Emilio-Guadarrama/MAGNIS-v1-GroundStation/Docs/MAGNIS-v1_Schematic.pdf

RGB Status Indicators — WS2812B | Magnetic Buzzer — MLT-8530 1 2 | R3

# ESP32-DevKitC V4

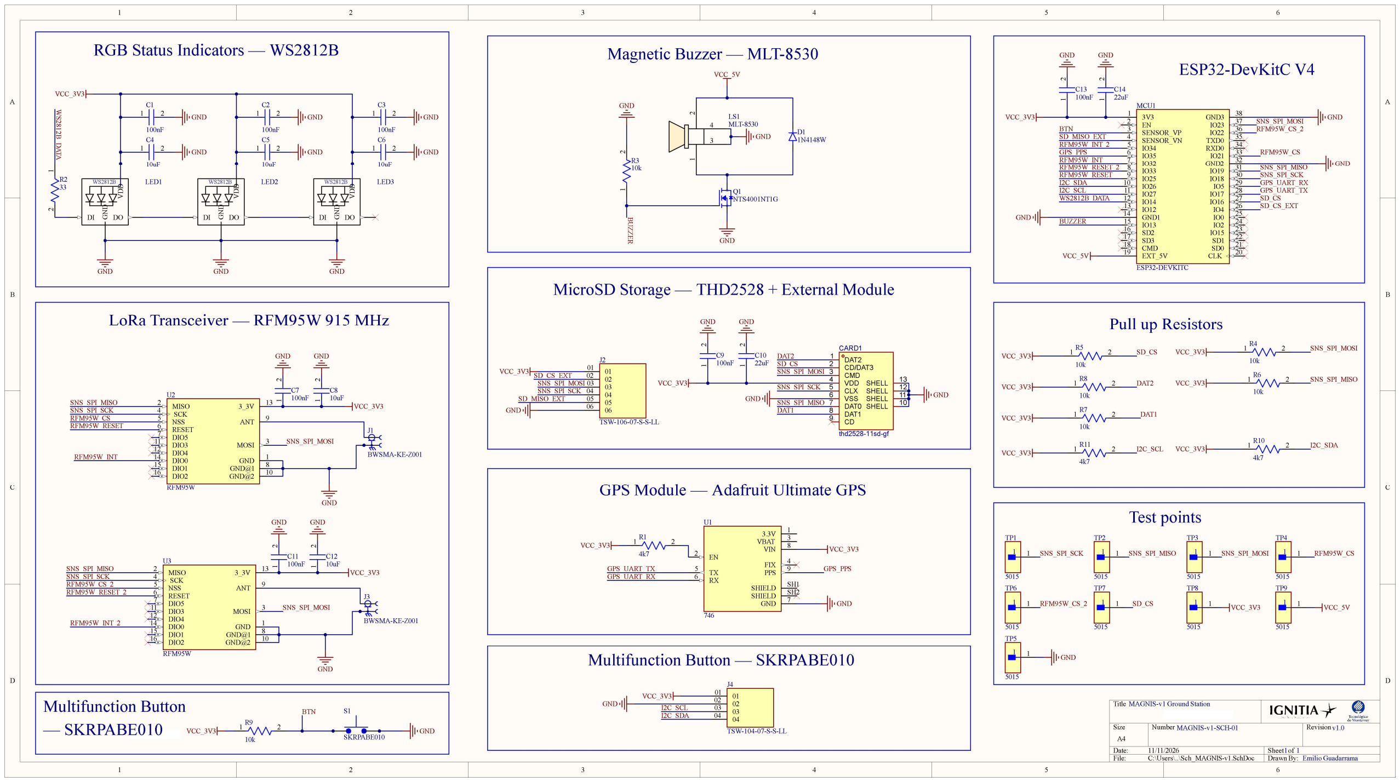
[picture p6: page 1]

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
Title

Size | Number | Revision
A4
Date: | 11/11/2026 | Sheet of
File: | C:\Users\..\Sch_MAGNIS-v1.SchDoc | Drawn By:

3V3 1
EN 2
SENSOR_VP 3
SENSOR_VN 4
IO34 5
IO35 6
IO32 7
IO33 8
IO25 9
IO26 10
IO27 11
IO14 12
IO12 13
GND1 14
IO13 15
SD2 16
SD3 17
CMD 18
EXT_5V 19
GND3 | 38
IO23 | 37
IO22 | 36
TXD0 | 35
RXD0 | 34
IO21 | 33
GND2 | 32
IO19 | 31
IO18 | 30
IO5 | 29
IO17 | 28
IO16 | 27
IO4 | 26
IO0 | 25
IO2 | 24
IO15 | 23
SD1 | 22
SD0 | 21
CLK | 20

MCU1

ESP32-DEVKITC

Emilio Guadarrama

1 1

v1.0

MAGNIS-v1 Ground Station

MAGNIS-v1-SCH-01

1 2
R2
33

1 2

C1

100nF

1 2

C4

10uF

GND

GND

1 2

C2

100nF

1 2

C5

10uF

GND

GND

1 2

C3

100nF

1 2

C6

10uF

GND

GND

GND | GND | GND

VCC_3V3

10k

GND

GND

VCC_5V

GND

WS2812B GND DOVDD

DI

LED1 | WS2812B GND DOVDD

DI

LED2 | WS2812BGND DOVDD

DI

LED3 | BUZZER WS2812B_DATA

VCC_5V

GND

GND

GND

VCC_3V3

J1

BWSMA-KE-Z001 ¹ ² C7

100nF 1 2 | C8
| 10uF
GND | GND

VCC_3V3

# LoRa Transceiver — RFM95W 915 MHz

GND

VCC_3V3

1 2 R1

4k7

VCC_3V3

# GPS Module — Adafruit Ultimate GPS

GND

RFM95W_RESET

SNS_SPI_MOSI

SNS_SPI_MISO
SNS_SPI_SCK
RFM95W_CS

RFM95W_INT

GPS_UART_TX
GPS_UART_RX

01 01
02 02
03 03
04 04
05 05
06 06

J2

TSW-106-07-S-S-LL

DAT2 1
CD/DAT3 2
CMD 3
VDD 4
CLX 5
VSS 6
DAT0 7
DAT1 8
CD 9
SHELL | 10 SHELL | 11 SHELL | 12 SHELL | 13

CARD1

thd2528-11sd-gf

VCC_3V3

GND

SNS_SPI_MOSI

SNS_SPI_SCK

SNS_SPI_MISO

DAT1 ¹ ² C9

100nF 1 2 | C10
| 22uF
GND | GND | Pull up Resistors

SNS_SPI_MOSI

SNS_SPI_MISO

DAT1

1 2 R4

10k

1 2 R6

10k

1 2 R7

10k

VCC_3V3

VCC_3V3

VCC_3V3

VCC_3V3
SNS_SPI_MOSI
SNS_SPI_SCK

GND

SD_MISO_EXT

DAT2

1 | 2 | DAT2 R8

10k

VCC_3V3

SD_CS

RFM95W_INT

RFM95W_RESET

WS2812B_DATA

GPS_UART_RX
GPS_UART_TX

SNS_SPI_SCK

SNS_SPI_MISO

SNS_SPI_MOSI

SD_CS

GPS_PPS

RFM95W_INT_2

SD_CS_EXT

SD_CS_EXT

RFM95W_CS

SD_MISO_EXT

1 | 2 | SD_CS R5

10k

VCC_3V3

GND

GPS_PPS

# MicroSD Storage — THD2528 + External Module

EN 2

TX 5
RX 6
3.3V | 1
VBAT | 3
VIN | 8
FIX | 4
PPS | 9
SHIELD | SH1
SHIELD | SH2
GND | 7

U1

746

MISO 2
SCK 4
NSS 5
RESET 6
DIO5 7
DIO3 11
DIO4 12
DIO0 14
DIO1 15
DIO2 16
3_3V | 13
ANT | 9
MOSI | 3
GND | 1
GND@1 | 8
GND@2 | 10

U2

RFM95W | 1 2 | 3
| | 4

LS1
MLT-8530
D1
1N4148W

Q1
NTS4001NT1G

J3

BWSMA-KE-Z001 ¹ ² C11

100nF 1 2 | C12
| 10uF
GND | GND

VCC_3V3

GND

RFM95W_RESET_2

SNS_SPI_MOSI

SNS_SPI_MISO
SNS_SPI_SCK
RFM95W_CS_2

RFM95W_INT_2

MISO 2
SCK 4
NSS 5
RESET 6
DIO5 7
DIO3 11
DIO4 12
DIO0 14
DIO1 15
DIO2 16
3_3V | 13
ANT | 9
MOSI | 3
GND | 1
GND@1 | 8
GND@2 | 10

U3

RFM95W

RFM95W_CS_2

RFM95W_RESET_2

BUZZER

Multifunction Button | S1

SKRPABE010

1 2 R9

10k

VCC_3V3

BTN

I2C_SDA

01 01
02 02
03 03
04 04

J4

TSW-104-07-S-S-LL

# Multifunction Button — SKRPABE010

VCC_3V3
GND | I2C_SCL
| I2C_SDA

I2C_SCL

# — SKRPABE010

# Test points

1 | 2 | I2C_SDA R10

4k7

1 | 2 | I2C_SCL | VCC_3V3 R11

4k7

VCC_3V3 | 1 2 | C13
100nF 1 2 | C14

22uF

GND | GND

1 1

TP1

5015

SNS_SPI_SCK

1 1

TP6

5015

RFM95W_CS_2

1 1

TP2

5015

SNS_SPI_MISO

1 1

TP7

5015

SD_CS

1 1

TP3

5015

SNS_SPI_MOSI

1 1

TP8

5015

1 1

TP4

5015

RFM95W_CS

1 1

TP9

5015

1 1

TP5

5015

VCC_3V3 | VCC_5V

GND

GND

BTN
