Emilio-Guadarrama/MAGNIS-v1-GroundStation/PCB_Project_MAGNIS-v1-GroundStation/Images/Background.jpg

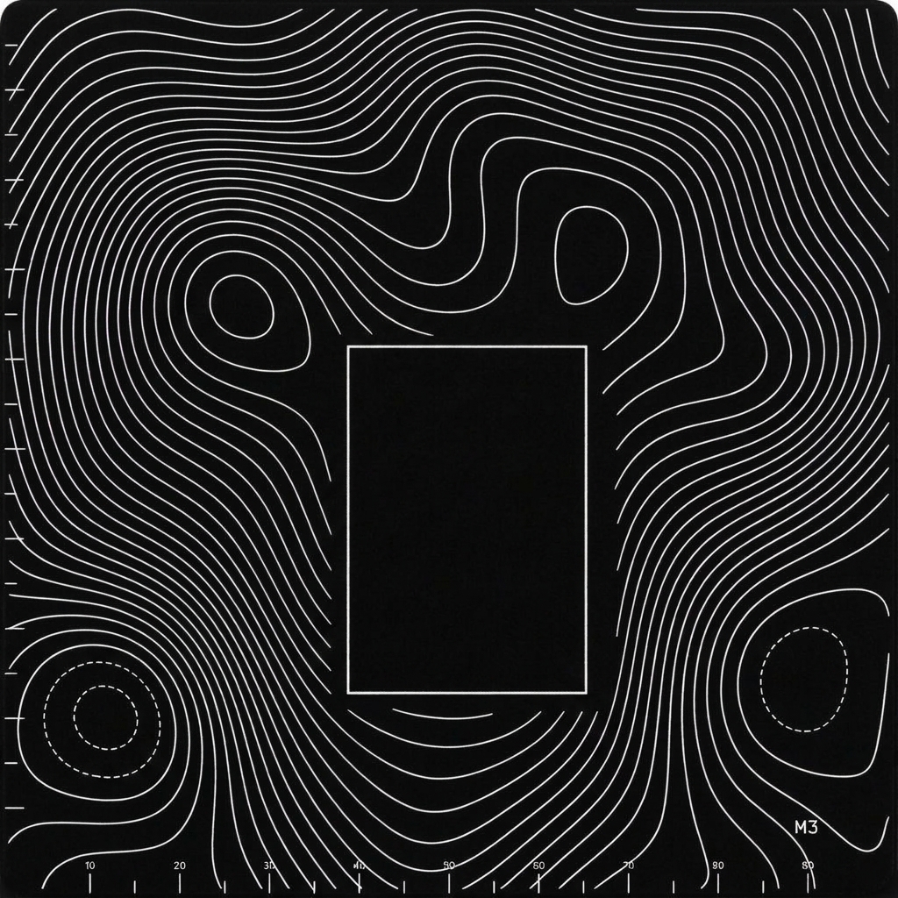
PCB_Project_MAGNIS-v1-GroundStation/Images/Background.jpg
