Emilio-Guadarrama/MAGNIS-v1-GroundStation/VESTA_v1_Parts_List.xlsx

VESTA v1 ground station component list (rev A) |  |  |  |  |  |  |  |  | Boards to build | 3 | ← edit: 2 boards for diversity + 1 spare (assumption, change freely)
Green = approved, at UNIT Electronics · White = reused from V5 (same part and footprint) · Yellow = needs a decision or a special order · Grey = DNP or PCB copper only. UNIT is the primary source (assembly in Mexico); LCSC, Mouser and DigiKey are backups. SnapMagic 'Part page' = dedicated symbol + footprint page; 'Search' = no dedicated page found, reuse the V5 footprint where noted. V5 links checked Sep 24, 2026; new UNIT links found Oct 29, 2026 — stock not re-checked, confirm at checkout.
Status | Component name | ID # (part number) | Designator on schematic | Amount | Total (all boards) | UNIT Electronics | LCSC | Mouser MX | DigiKey MX | SnapMagic (symbol + footprint) | Notes
MODULES (plug-in, no soldering to the module itself)
Approved | Dev board ESP32-DevKitC V4, ESP32-WROOM-32D (4 MB flash, PCB antenna, 2×19 pins, CP2102 micro-USB) | ESP32-DevKitC-32D | MOD1 | 1 | 3 | UNIT (https://uelectronics.com/producto/esp32-devkitc-v4-esp32-wroom-32d-32u/) | — | Mouser (https://www.mouser.mx/c/?q=ESP32-DevKitC-32D) | DigiKey (https://www.digikey.com.mx/es/products/result?keywords=ESP32-DevKitC-32D) | Part page (ESP32-DEVKITC) (https://www.snapeda.com/parts/ESP32-DEVKITC/Espressif%20Systems/view-part/) | UNIT $145 MXN — choose the '32D' option (PCB antenna). The '32U' needs an external IPEX antenna. Wi-Fi is only for debug, so 32D is enough; keep copper out from under its antenna. Check that the SnapMagic symbol pin numbers match the DevKit J2/J3 order and measure the row spacing on the real board.
Request from UNIT | GPS breakout MTK3339 / PA1616S (66 ch, 10 Hz, patch antenna) | Adafruit 746 | MOD2 | 1 | 3 | Request | — | Mouser (https://www.mouser.mx/c/?q=Adafruit%20746) | DigiKey (https://www.digikey.com.mx/es/products/result?keywords=Adafruit%20746) | Not needed — mounts on J4 | Not stocked at UNIT: request a special order (allow lead time). Pin order 3.3V, EN, VBAT, FIX, TX, RX, GND, VIN, PPS — check the breakout silkscreen. VIN = 5 V; EN left NC (pull-up on breakout).
Approved | MicroSD SPI module, 6-pin (optional test module for J3) | Generic micro SD reader | MOD3 | 1 | 3 | UNIT (https://uelectronics.com/producto/lector-de-memorias-micro-sd-para-arduino/) | — | — | — | Not needed — plugs into J3 | Only for testing the backup path. Its buffer never releases MISO → own SD_MISO_EXT line (IO35). Most of these modules have an onboard LDO: set JP2 to 5 V.
POWER
Approved | LDO 3.3 V / 600 mA, 250 mV dropout, SOT-23-5 | AP2112K-3.3TRG1 | U1 | 1 | 3 | UNIT (https://uelectronics.com/producto/regulador-de-voltaje-lineal-ap2112k-3-3trg1/) | C51118 (https://www.lcsc.com/product-detail/C51118.html) | Mouser (https://www.mouser.mx/c/?q=AP2112K-3.3TRG1) | DigiKey (https://www.digikey.com.mx/es/products/result?keywords=AP2112K-3.3TRG1) | Part page (https://www.snapeda.com/parts/AP2112K-3.3TRG1/Diodes%20Inc./view-part/) | Replaces AMS1117-3.3: AMS1117 needs ≥1.1 V headroom and the DevKit 5V pin sits below 5 V on laptop USB. EN tied to VIN. Built-in current limit.
PCB only | Solder jumper, 3-pad | PCB copper only | JP1, JP2 | 2 | 0 | — | — | — | — | — | JP1 = VCC_3V3 source (U1 or devkit 3V3). JP2 = J3 VCC (5 V or 3V3). Nothing to buy.
RF
Reuse (V5 part) | LoRa transceiver 915 MHz (SX1276) | RFM95W-915S2 | U2 | 1 | 3 | UNIT (https://uelectronics.com/producto/rfm95w-915mhz-transceptor-lora/) | C6760738 (https://www.lcsc.com/product-detail/C6760738.html) | Mouser (https://www.mouser.mx/c/?q=RFM95W-915S2) | DigiKey (https://www.digikey.com.mx/es/products/result?keywords=RFM95W-915S2) | Part page (https://www.snapeda.com/parts/RFM95W-915S2/HOPERF/view-part/) | Same part and footprint as V5. ANT pad faces J1; CPWG trace ≤ 6 mm (W 1.0 mm / gap 0.18 mm, L2 = GND).
Reuse (V5 part) | SMA edge connector 50 Ω | BWSMA-KE-Z001 | J1 | 1 | 3 | UNIT (https://uelectronics.com/producto/conectores-sma-hembra-vertical-y-horizontal/) | C496549 (https://www.lcsc.com/product-detail/C496549.html) | Mouser (https://www.mouser.mx/c/?q=BWSMA-KE-Z001) | DigiKey (https://www.digikey.com.mx/es/products/result?keywords=BWSMA-KE-Z001) | Search (https://www.snapeda.com/search/?q=BWSMA-KE-Z001) | Same as V5. Must be edge-launch for a 1.6 mm board — UNIT listing is generic SMA, confirm edge-mount. No SnapMagic page: reuse the V5 footprint. GND legs = Direct Connect.
Approved | Resistor 0 Ω 0603 (π-match series) | 0603WAF0000T5E | R1 | 1 | 3 | UNIT (https://uelectronics.com/producto/resistencias-smd-0603/) | Search (https://www.lcsc.com/search?q=0603WAF0000T5E) | Mouser (https://www.mouser.mx/c/?q=0603WAF0000T5E) | DigiKey (https://www.digikey.com.mx/es/products/result?keywords=0603WAF0000T5E) | Generic — use your 0603/0805 library | Fitted by default. Swap for an inductor/capacitor only if VNA tuning says so.
DNP (footprint only) | Capacitor 0603 (π-match shunts) | — | C1, C2 | 2 | 0 | — | — | — | — | Generic — use your 0603/0805 library | Footprint only, do not populate. Values chosen after VNA tuning.
CONNECTORS & HEADERS
Reuse (V5 part) | MicroSD socket push-push (no card detect) | THD2528-11SD-GF | J2 | 1 | 3 | UNIT (https://uelectronics.com/producto/thd2528-11sd-gf-conector-para-memoria-micro-sd/) | C283232 (https://www.lcsc.com/product-detail/C283232.html) | Mouser (https://www.mouser.mx/c/?q=THD2528-11SD-GF) | DigiKey (https://www.digikey.com.mx/es/products/result?keywords=THD2528-11SD-GF) | Search (https://www.snapeda.com/search/?q=THD2528-11SD-GF) | Same socket as V5 → the GS validates it before V5 assembly. No card-detect, so no SD_DETECT line. No SnapMagic page: reuse the V5 footprint.
Approved | Female header 1×19, 2.54 mm (DevKitC sockets) | PPTC191LFBN-RC | J5, J6 | 2 | 6 | UNIT (https://uelectronics.com/producto/tira-header-hembra-2-54mm-diferentes-pines/) | — | Mouser (https://www.mouser.mx/c/?q=PPTC191LFBN-RC) | DigiKey (https://www.digikey.com.mx/es/products/result?keywords=PPTC191LFBN-RC) | Search (https://www.snapeda.com/search/?q=PPTC191LFBN-RC) | UNIT sells strips by pin count — buy 1×40 and cut (one pin lost per cut). Sullins PN is the footprint reference.
Approved | Female header 1×9, 2.54 mm (GPS breakout) | PPTC091LFBN-RC | J4 | 1 | 3 | UNIT (https://uelectronics.com/producto/tira-header-hembra-2-54mm-diferentes-pines/) | — | Mouser (https://www.mouser.mx/c/?q=PPTC091LFBN-RC) | DigiKey (https://www.digikey.com.mx/es/products/result?keywords=PPTC091LFBN-RC) | Search (https://www.snapeda.com/search/?q=PPTC091LFBN-RC) | Order must match the Adafruit 746 breakout. Keep J4 at the opposite corner from J1 (~60 mm).
Approved | Female header 1×6, 2.54 mm (external microSD module) | PPTC061LFBN-RC | J3 | 1 | 3 | UNIT (https://uelectronics.com/producto/tira-header-hembra-2-54mm-diferentes-pines/) | — | Mouser (https://www.mouser.mx/c/?q=PPTC061LFBN-RC) | DigiKey (https://www.digikey.com.mx/es/products/result?keywords=PPTC061LFBN-RC) | Search (https://www.snapeda.com/search/?q=PPTC061LFBN-RC) | Match the module pin order (typ. GND, VCC, MISO, MOSI, SCK, CS — check the module silkscreen).
Approved | Male header 1×2, 2.54 mm (MODE_SEL) | PRPC002SAAN-RC | J7 | 1 | 3 | UNIT (https://uelectronics.com/producto/tira-header-macho-40p-2-54mm-diferentes-colores/) | — | Mouser (https://www.mouser.mx/c/?q=PRPC002SAAN-RC) | DigiKey (https://www.digikey.com.mx/es/products/result?keywords=PRPC002SAAN-RC) | Search (https://www.snapeda.com/search/?q=PRPC002SAAN-RC) | Cut from a 1×40 male strip. Open = rocket config, jumper fitted = CanSat config (read at boot).
Approved | Jumper shunt 2.54 mm | QPC02SXGN-RC | — (on J7) | 1 | 3 | UNIT (https://uelectronics.com/producto/puente-corto-circuito-pin-header-2-54mm/) | — | Mouser (https://www.mouser.mx/c/?q=QPC02SXGN-RC) | DigiKey (https://www.digikey.com.mx/es/products/result?keywords=QPC02SXGN-RC) | Not needed — no footprint | Mechanical only.
PCB only | Mounting hole M3, plated | PCB copper only | H1, H2, H3, H4 | 4 | 0 | — | — | — | — | — | 3.5 mm from each corner. Nothing to buy (standoffs optional).
INDICATORS & AUDIO
Reuse (V5 part) | Addressable RGB LED 5050 | WS2812B-B/T | LED1, LED2, LED3 | 3 | 9 | UNIT (https://uelectronics.com/producto/neopixel-rgb-5x5mm-smd-ws2812b-b/) | C2761795 (https://www.lcsc.com/product-detail/C2761795.html) | Mouser (https://www.mouser.mx/c/?q=WS2812B-B/T) | DigiKey (https://www.digikey.com.mx/es/products/result?keywords=WS2812B-B/T) | Search (https://www.snapeda.com/search/?q=WS2812B-B/T) | Same as V5 — reuse the corrected LED5050 footprint. VDD = 5 V.
Pending decision | Buffer 3.3 → 5 V, single, SOT-23-5 (WS2812B data) | SN74AHCT1G125DBVR | U3 | 1 | 3 | — | Search (https://www.lcsc.com/search?q=SN74AHCT1G125DBVR) | Mouser (https://www.mouser.mx/c/?q=SN74AHCT1G125DBVR) | DigiKey (https://www.digikey.com.mx/es/products/result?keywords=SN74AHCT1G125DBVR) | Part page (https://www.snapeda.com/parts/SN74AHCT1G125DBVR/Texas%20Instruments/view-part/) | Not at UNIT → Mouser/DigiKey MX. Needed because WS2812B at 5 V wants VIH ≥ 3.5 V. If not bought: leave U3 empty and fit R3 (direct drive, same as the FC).
DNP (footprint only) | Resistor 0 Ω 0603 (bypass for U3) | 0603WAF0000T5E | R3 | 1 | 0 | UNIT (https://uelectronics.com/producto/resistencias-smd-0603/) | Search (https://www.lcsc.com/search?q=0603WAF0000T5E) | Mouser (https://www.mouser.mx/c/?q=0603WAF0000T5E) | DigiKey (https://www.digikey.com.mx/es/products/result?keywords=0603WAF0000T5E) | Generic — use your 0603/0805 library | Fit only if U3 is not populated.
Reuse (V5 part) | Red LED 0805 (power indicators) | NCD0805R1 | D1, D2, D3 | 3 | 9 | UNIT (https://uelectronics.com/producto/led-rojo-smd-0805-ncd0805r1/) | C84256 (https://www.lcsc.com/product-detail/C84256.html) | Mouser (https://www.mouser.mx/c/?q=NCD0805R1) | DigiKey (https://www.digikey.com.mx/es/products/result?keywords=NCD0805R1) | Search (https://www.snapeda.com/search/?q=NCD0805R1) | D1 = VCC_5V, D2 = VCC_3V3, D3 = RFM95W rail. Series 1 kΩ each (R4–R6).
Approved | Active buzzer 5 V, 12 mm, THT | Generic active buzzer 5 V (ref. AI-1223-TWT-5V-R) | LS1 | 1 | 3 | UNIT (https://uelectronics.com/producto/buzzer-activo-3v-5v-12v-zumbador/) | — | Mouser (https://www.mouser.mx/c/?q=AI-1223-TWT-5V-R) | DigiKey (https://www.digikey.com.mx/es/products/result?keywords=AI-1223-TWT-5V-R) | Search (https://www.snapeda.com/search/?q=AI-1223-TWT-5V-R) | Replaces V5 MLT-8530 (not at UNIT). Active type: GPIO on/off, no PWM. Pick the 5 V variant on the UNIT page; check pin pitch (typ. 7.6 mm) and polarity before freezing the footprint.
TRANSISTORS & DIODES
Reuse (V5 part) | NPN 25 V / 500 mA, SOT-23 (buzzer driver) | S8050 | Q1 | 1 | 3 | UNIT (https://uelectronics.com/producto/transistor-npn-500ma-25v-s8050/) | C2146 (https://www.lcsc.com/product-detail/C2146.html) | Mouser (https://www.mouser.mx/c/?q=S8050) | DigiKey (https://www.digikey.com.mx/es/products/result?keywords=S8050) | Search (https://www.snapeda.com/search/?q=S8050) | Same as V5 — reuse its footprint and pinout. Base 1 kΩ (R7) + 10 kΩ pull-down (R14) keeps LS1 quiet during boot.
Reuse (V5 part) | Switching diode (buzzer flyback) | 1N4148W | D4 | 1 | 3 | UNIT (https://uelectronics.com/producto/1n4148w-diodo-75v-150ma-smd/) | C81598 (https://www.lcsc.com/product-detail/C81598.html) | Mouser (https://www.mouser.mx/c/?q=1N4148W) | DigiKey (https://www.digikey.com.mx/es/products/result?keywords=1N4148W) | Part page (1N4148W-7-F, SOD-123) (https://www.snapeda.com/parts/1N4148W-7-F/Diodes%20Inc./view-part/) | Across LS1. Confirm the UNIT part is SOD-123 to match the SnapMagic footprint.
RESISTORS 0603 1 %
Approved | Resistor 47 Ω | 0603WAF470JT5E | R2 | 1 | 3 | UNIT (https://uelectronics.com/producto/resistencias-smd-0603/) | Search (https://www.lcsc.com/search?q=0603WAF470JT5E) | Mouser (https://www.mouser.mx/c/?q=0603WAF470JT5E) | DigiKey (https://www.digikey.com.mx/es/products/result?keywords=0603WAF470JT5E) | Generic — use your 0603/0805 library | WS2812B DIN series (47 Ω per FC change list).
Reuse (V5 part) | Resistor 1 kΩ | 0603WAF1001T5E | R4, R5, R6, R7 | 4 | 12 | UNIT (https://uelectronics.com/producto/resistencias-smd-0603/) | C21190 (https://www.lcsc.com/product-detail/C21190.html) | Mouser (https://www.mouser.mx/c/?q=0603WAF1001T5E) | DigiKey (https://www.digikey.com.mx/es/products/result?keywords=0603WAF1001T5E) | Generic — use your 0603/0805 library | R4–R6 LED series, R7 Q1 base.
Reuse (V5 part) | Resistor 10 kΩ | 0603WAF1002T5E | R8, R9, R10, R11, R12, R13, R14 | 7 | 21 | UNIT (https://uelectronics.com/producto/resistencias-smd-0603/) | C25804 (https://www.lcsc.com/product-detail/C25804.html) | Mouser (https://www.mouser.mx/c/?q=0603WAF1002T5E) | DigiKey (https://www.digikey.com.mx/es/products/result?keywords=0603WAF1002T5E) | Generic — use your 0603/0805 library | R8–R12 SD slot pull-ups (CS, CMD/MOSI, DAT0/MISO, DAT1, DAT2); R13 MODE_SEL pull-up; R14 Q1 base pull-down.
CAPACITORS 0805
Reuse (V5 part) | Capacitor 100 nF 50 V X7R | CC0805KRX7R9BB104 | C8, C10, C13, C14, C15, C16, C17 | 7 | 21 | UNIT (https://uelectronics.com/producto/cc0805krx7r9bb104-capacitor-ceramico-0805-100nf-50v/) | C49678 (https://www.lcsc.com/product-detail/C49678.html) | Mouser (https://www.mouser.mx/c/?q=CC0805KRX7R9BB104) | DigiKey (https://www.digikey.com.mx/es/products/result?keywords=CC0805KRX7R9BB104) | Generic — use your 0603/0805 library | C8 RFM95W, C10 SD slot, C13 GPS, C14 U3, C15–C17 WS2812B.
Reuse (V5 part) | Capacitor 10 µF 25 V X5R | CL21A106KAYNNNE | C3, C6, C7, C9, C11, C12 | 6 | 18 | UNIT (https://uelectronics.com/producto/tmk212bbj106kg-t-capacitor-ceramico-0805-10uf-25v/) | C15850 (https://www.lcsc.com/product-detail/C15850.html) | Mouser (https://www.mouser.mx/c/?q=CL21A106KAYNNNE) | DigiKey (https://www.digikey.com.mx/es/products/result?keywords=CL21A106KAYNNNE) | Generic — use your 0603/0805 library | C3 VCC_5V bulk, C6 VCC_3V3 bulk, C7 RFM95W, C9 SD slot, C11 J3, C12 GPS VIN. UNIT part is TMK212BBJ106KG-T (same spec).
Reuse (V5 part) | Capacitor 1 µF 50 V X7R | CL21B105KBFNNNE | C4, C5 | 2 | 6 | UNIT (https://uelectronics.com/producto/capacitor-ceramico-0805-1uf-50v-tcc0805x7r105k500dts/) | C28323 (https://www.lcsc.com/product-detail/C28323.html) | Mouser (https://www.mouser.mx/c/?q=CL21B105KBFNNNE) | DigiKey (https://www.digikey.com.mx/es/products/result?keywords=CL21B105KBFNNNE) | Generic — use your 0603/0805 library | U1 input / output (AP2112K needs ≥1 µF). UNIT part is TCC0805X7R105K500DTS (same spec).
 | Parts placed per board (excl. DNP and PCB-only rows) |  |  | 51
 | Parts to order for all boards |  |  | 153
 | Parts found at UNIT Electronics (lines) |  |  | 23 of 25
