Emilio-Guadarrama/MAGNIS-v1-GroundStation/BOM/VESTA_v1_Parts_List.xlsx

VESTA v1 ground station component list (schematic VESTA-v1-SCH-01, rev 1.0) |  |  |  |  |  |  |  |  | Boards to build | 3 | ← edit: 2 boards for diversity + 1 spare (assumption, change freely)
Green = approved, at UNIT Electronics · White = reused from V5 (same part and footprint) · Yellow = needs a decision or a special order · Grey = DNP or PCB copper only. Designators and quantities match Sch_VESTA-v1.NET (Oct 29, 2026). UNIT is the primary source (assembly in Mexico); LCSC, Mouser and DigiKey are backups. SnapMagic 'Part page' = dedicated symbol + footprint page; 'Search' = no dedicated page found, reuse the V5 footprint where noted. V5 links checked Sep 24, 2026; new UNIT links found Oct 29, 2026 — stock not re-checked, confirm at checkout.
Status | Component name | ID # (part number) | Designator on schematic | Amount | Total (all boards) | UNIT Electronics | LCSC | Mouser MX | DigiKey MX | SnapMagic (symbol + footprint) | Notes
MODULES (plug-in, no soldering to the module itself)
Approved | Dev board ESP32-DevKitC V4, ESP32-WROOM-32D (4 MB flash, PCB antenna, 2×19 pins, CP2102 micro-USB) | ESP32-DevKitC-32D | MCU1 | 1 | 3 | UNIT (https://uelectronics.com/producto/esp32-devkitc-v4-esp32-wroom-32d-32u/) | — | Mouser (https://www.mouser.mx/c/?q=ESP32-DevKitC-32D) | DigiKey (https://www.digikey.com.mx/es/products/result?keywords=ESP32-DevKitC-32D) | Part page (ESP32-DEVKITC) (https://www.snapeda.com/parts/ESP32-DEVKITC/Espressif%20Systems/view-part/) | UNIT $145 MXN — choose the '32D' option (PCB antenna). Footprint MODULE_ESP32-DEVKITC; plugs into the two 1×19 female sockets below. Keep copper out from under its antenna.
Request from UNIT | GPS breakout MTK3339 / PA1616S (66 ch, 10 Hz, patch antenna) | Adafruit 746 | U1 | 1 | 3 | Request | — | Mouser (https://www.mouser.mx/c/?q=Adafruit%20746) | DigiKey (https://www.digikey.com.mx/es/products/result?keywords=Adafruit%20746) | Footprint XCVR_746 (in schematic) | Not stocked at UNIT: request a special order (allow lead time). Plugs into the 1×9 female socket below. VIN on 3.3 V, VBAT left open (optional CR1220 on the breakout).
Approved | MicroSD SPI module, 6-pin (optional test module for J2) | Generic micro SD reader | — (on J2) | 1 | 3 | UNIT (https://uelectronics.com/producto/lector-de-memorias-micro-sd-para-arduino/) | — | — | — | Not needed — plugs into J2 | Only for testing the backup path. Own CS (IO4) and own MISO (IO39). J2 gives 3.3 V only: use a module without onboard LDO, or bypass it.
SOCKETS FOR THE MODULES (mechanical, no schematic symbol)
Approved | Female header 1×19, 2.54 mm (DevKitC sockets) | PPTC191LFBN-RC | — (MCU1) | 2 | 6 | UNIT (https://uelectronics.com/producto/tira-header-hembra-2-54mm-diferentes-pines/) | — | Mouser (https://www.mouser.mx/c/?q=PPTC191LFBN-RC) | DigiKey (https://www.digikey.com.mx/es/products/result?keywords=PPTC191LFBN-RC) | Not needed | Soldered into the MCU1 footprint holes. UNIT sells strips by pin count — cut from a 1×40.
Approved | Female header 1×9, 2.54 mm (GPS breakout socket) | PPTC091LFBN-RC | — (U1) | 1 | 3 | UNIT (https://uelectronics.com/producto/tira-header-hembra-2-54mm-diferentes-pines/) | — | Mouser (https://www.mouser.mx/c/?q=PPTC091LFBN-RC) | DigiKey (https://www.digikey.com.mx/es/products/result?keywords=PPTC091LFBN-RC) | Not needed | Soldered into the U1 (XCVR_746) footprint holes.
RF
Reuse (V5 part) | LoRa transceiver 915 MHz (SX1276) | RFM95W-915S2 | U3 | 1 | 3 | UNIT (https://uelectronics.com/producto/rfm95w-915mhz-transceptor-lora/) | C6760738 (https://www.lcsc.com/product-detail/C6760738.html) | Mouser (https://www.mouser.mx/c/?q=RFM95W-915S2) | DigiKey (https://www.digikey.com.mx/es/products/result?keywords=RFM95W-915S2) | Part page (https://www.snapeda.com/parts/RFM95W-915S2/HOPERF/view-part/) | Order the 915 MHz part. Schematic footprint is named XCVR_RFM95W-868S2 — same land pattern.
Reuse (V5 part) | SMA edge connector 50 Ω | BWSMA-KE-Z001 | J1 | 1 | 3 | UNIT (https://uelectronics.com/producto/conectores-sma-hembra-vertical-y-horizontal/) | C496549 (https://www.lcsc.com/product-detail/C496549.html) | Mouser (https://www.mouser.mx/c/?q=BWSMA-KE-Z001) | DigiKey (https://www.digikey.com.mx/es/products/result?keywords=BWSMA-KE-Z001) | Search (https://www.snapeda.com/search/?q=BWSMA-KE-Z001) | Same as V5. Must be edge-launch for a 1.6 mm board — UNIT listing is generic SMA, confirm edge-mount. GND legs = Direct Connect. Short CPWG trace from U3 ANT.
STORAGE
Reuse (V5 part) | MicroSD socket push-push, with card-detect pad | THD2528-11SD-GF | CARD1 | 1 | 3 | UNIT (https://uelectronics.com/producto/thd2528-11sd-gf-conector-para-memoria-micro-sd/) | C283232 (https://www.lcsc.com/product-detail/C283232.html) | Mouser (https://www.mouser.mx/c/?q=THD2528-11SD-GF) | DigiKey (https://www.digikey.com.mx/es/products/result?keywords=THD2528-11SD-GF) | Search (https://www.snapeda.com/search/?q=THD2528-11SD-GF) | Same socket as V5. Pin 9 (CD) left open on purpose (its switch closes to the shell = GND). Shell pins 10–13 to GND. Two Ø1.00 mm locating pegs = non-plated holes.
Pending decision | Header 1×6, 2.54 mm (external microSD module) | TSW-106-07-S-S-LL | J2 | 1 | 3 | UNIT (https://uelectronics.com/producto/tira-header-hembra-2-54mm-diferentes-pines/) | — | Mouser (https://www.mouser.mx/c/?q=TSW-106-07-S-S-LL) | DigiKey (https://www.digikey.com.mx/es/products/result?keywords=TSW-106-07-S-S-LL) | Search (https://www.snapeda.com/search/?q=TSW-106-07-S-S-LL) | Schematic part is a MALE strip, but the microSD modules also come with male pins. Fit a 1×6 FEMALE socket (PPTC061LFBN-RC, same footprint) — UNIT link is the female strip.
INDICATORS & AUDIO
Reuse (V5 part) | Addressable RGB LED 5050 | WS2812B-B/T | LED1, LED2, LED3 | 3 | 9 | UNIT (https://uelectronics.com/producto/neopixel-rgb-5x5mm-smd-ws2812b-b/) | C2761795 (https://www.lcsc.com/product-detail/C2761795.html) | Mouser (https://www.mouser.mx/c/?q=WS2812B-B/T) | DigiKey (https://www.digikey.com.mx/es/products/result?keywords=WS2812B-B/T) | Search (https://www.snapeda.com/search/?q=WS2812B-B/T) | VDD on VCC_3V3, data from IO26 through R2. Footprint checked by the designer.
Reuse (V5 part) | Magnetic buzzer 2.7 kHz (passive) | MLT-8530 | LS1 | 1 | 3 | — | C94599 (https://www.lcsc.com/product-detail/C94599.html) | Mouser (https://www.mouser.mx/c/?q=MLT-8530) | DigiKey (https://www.digikey.com.mx/es/products/result?keywords=MLT-8530) | Search (https://www.snapeda.com/search/?q=MLT-8530) | Same part and circuit as the IGNIS FC, validated there on 5 V with PWM. Not at UNIT. Pins 3–4 mechanical (GND).
Reuse (V5 part) | N-MOSFET 30 V / 270 mA (SC-70), buzzer driver | NTS4001NT1G | Q1 | 1 | 3 | — | C116738 (https://www.lcsc.com/product-detail/C116738.html) | Mouser (https://www.mouser.mx/c/?q=NTS4001NT1G) | DigiKey (https://www.digikey.com.mx/es/products/result?keywords=NTS4001NT1G) | Search (https://www.snapeda.com/search/?q=NTS4001NT1G) | Same as the IGNIS FC buzzer driver. Not at UNIT. Gate from IO27, pull-down R3.
Reuse (V5 part) | Switching diode (buzzer flyback) | 1N4148W-7 | D1 | 1 | 3 | UNIT (https://uelectronics.com/producto/1n4148w-diodo-75v-150ma-smd/) | C81598 (https://www.lcsc.com/product-detail/C81598.html) | Mouser (https://www.mouser.mx/c/?q=1N4148W-7) | DigiKey (https://www.digikey.com.mx/es/products/result?keywords=1N4148W-7) | Part page (1N4148W-7-F) (https://www.snapeda.com/parts/1N4148W-7-F/Diodes%20Inc./view-part/) | SOD-123 (footprint SOD3715X135N). Across LS1.
RESISTORS 0603 1 %
Approved | Resistor 4.7 kΩ | 0603WAF4701T5E | R1 | 1 | 3 | UNIT (https://uelectronics.com/producto/resistencias-smd-0603/) | C23162 (https://www.lcsc.com/product-detail/C23162.html) | Mouser (https://www.mouser.mx/c/?q=0603WAF4701T5E) | DigiKey (https://www.digikey.com.mx/es/products/result?keywords=0603WAF4701T5E) | Generic — use your 0603/0805 library | GPS EN pull-up to 3.3 V.
Approved | Resistor 33 Ω | 0603WAF330JT5E | R2 | 1 | 3 | UNIT (https://uelectronics.com/producto/resistencias-smd-0603/) | C23140 (https://www.lcsc.com/product-detail/C23140.html) | Mouser (https://www.mouser.mx/c/?q=0603WAF330JT5E) | DigiKey (https://www.digikey.com.mx/es/products/result?keywords=0603WAF330JT5E) | Generic — use your 0603/0805 library | WS2812B data series resistor, at LED1.
Reuse (V5 part) | Resistor 10 kΩ | 0603WAF1002T5E | R3, R4, R5, R6, R7, R8 | 6 | 18 | UNIT (https://uelectronics.com/producto/resistencias-smd-0603/) | C25804 (https://www.lcsc.com/product-detail/C25804.html) | Mouser (https://www.mouser.mx/c/?q=0603WAF1002T5E) | DigiKey (https://www.digikey.com.mx/es/products/result?keywords=0603WAF1002T5E) | Generic — use your 0603/0805 library | R3 buzzer gate pull-down; pull-ups to 3.3 V: R4 MOSI, R5 SD_CS, R6 MISO, R7 DAT1, R8 DAT2.
CAPACITORS 0805
Reuse (V5 part) | Capacitor 100 nF 50 V X7R | CC0805KRX7R9BB104 | C1, C2, C3, C7, C9 | 5 | 15 | UNIT (https://uelectronics.com/producto/cc0805krx7r9bb104-capacitor-ceramico-0805-100nf-50v/) | C49678 (https://www.lcsc.com/product-detail/C49678.html) | Mouser (https://www.mouser.mx/c/?q=CC0805KRX7R9BB104) | DigiKey (https://www.digikey.com.mx/es/products/result?keywords=CC0805KRX7R9BB104) | Generic — use your 0603/0805 library | C1–C3 WS2812B, C7 RFM95W, C9 microSD.
Reuse (V5 part) | Capacitor 10 µF 25 V X5R | CL21A106KAYNNNE | C4, C5, C6, C8 | 4 | 12 | UNIT (https://uelectronics.com/producto/tmk212bbj106kg-t-capacitor-ceramico-0805-10uf-25v/) | C15850 (https://www.lcsc.com/product-detail/C15850.html) | Mouser (https://www.mouser.mx/c/?q=CL21A106KAYNNNE) | DigiKey (https://www.digikey.com.mx/es/products/result?keywords=CL21A106KAYNNNE) | Generic — use your 0603/0805 library | C4–C6 WS2812B, C8 RFM95W. UNIT part is TMK212BBJ106KG-T (same spec).
Reuse (V5 part) | Capacitor 22 µF 25 V X5R | CL21A226MAQNNNE | C10 | 1 | 3 | UNIT (https://uelectronics.com/producto/cl21a226maqnnne-capacitor-ceramico-0805-22uf-25v/) | C45783 (https://www.lcsc.com/product-detail/C45783.html) | Mouser (https://www.mouser.mx/c/?q=CL21A226MAQNNNE) | DigiKey (https://www.digikey.com.mx/es/products/result?keywords=CL21A226MAQNNNE) | Generic — use your 0603/0805 library | microSD bulk capacitor.
 | Parts placed per board (excl. DNP and PCB-only rows) |  |  | 34
 | Parts to order for all boards |  |  | 102
 | Parts found at UNIT Electronics (lines) |  |  | 16 of 19
