Emilio-Guadarrama/MAGNIS-v1-GroundStation/PCB_Project_VESTA-v1-GroundStation/Components/NTS4001NT1G - SC-70 (Buzzer)/NTS4001NT1G/NTS4001NT1G.STEP

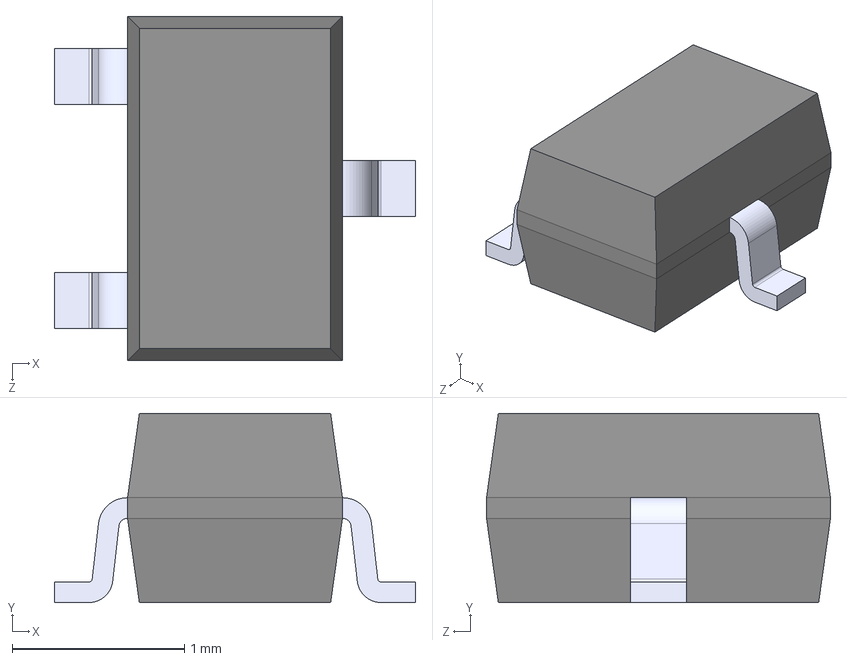
[picture p8: CAD file, 2026-10-30]
PCB_Project_VESTA-v1-GroundStation/Components/NTS4001NT1G - SC-70 (Buzzer)/NTS4001NT1G/NTS4001NT1G.STEP
2.10 x 1.10 x 2.00 mm
