Emilio-Guadarrama/MAGNIS-v1-GroundStation/(list of files, drawings)

Other design files:
PCB_Project_MAGNIS-v1-GroundStation/Components/Button - SKRPABE010 Micro Switch/SKRPABE010/SKRPABE010.SchLib
PCB_Project_MAGNIS-v1-GroundStation/Components/Button - SKRPABE010 Micro Switch/SKRPABE010/SW_SKRPABE010.PcbLib
PCB_Project_MAGNIS-v1-GroundStation/Components/Buzzer - BWSMA-KE-Z001 or CMI-1275C-050/MLT-8530/MLT-8530.SchLib
PCB_Project_MAGNIS-v1-GroundStation/Components/ESP32-DEVKIT/ESP32-DEVKITC/MODULE_ESP32-DEVKITC.PcbLib
PCB_Project_MAGNIS-v1-GroundStation/Components/GPS - Ultimate GPS Breakout 66 channel Adafruit/GPS/746.SchLib
PCB_Project_MAGNIS-v1-GroundStation/Components/Pin header 4/TSW-104-07-S-S-LL/SAMTEC_TSW-104-07-S-S-LL.PcbLib
PCB_Project_MAGNIS-v1-GroundStation/Components/Pin header 4/TSW-104-07-S-S-LL/TSW-104-07-S-S-LL.SchLib
PCB_Project_MAGNIS-v1-GroundStation/Components/Pin header/TSW-106-07-S-S-LL/TSW-106-07-S-S-LL.SchLib
PCB_Project_MAGNIS-v1-GroundStation/Components/RF Module (LoRa) - RFM95W/Antenna-RFM95W-868S2/RFM95W-868S2.SchLib
PCB_Project_MAGNIS-v1-GroundStation/Components/SMA port - BWSMA-KE-Z001/SMA/BAT_WIRELESS_BWSMA-KE-Z001.PcbLib
PCB_Project_MAGNIS-v1-GroundStation/Components/Switching diode (buzzer flyback) - 1N4148W/1N4148W/1N4148W.SchLib
PCB_Project_MAGNIS-v1-GroundStation/PCB_MAGNIS-v1.pcb
PCB_Project_MAGNIS-v1-GroundStation/PCB_MAGNIS-v1.PcbDoc
PCB_Project_MAGNIS-v1-GroundStation/PCB_Project_MAGNIS-v1-GroundStation.PrjPcb
PCB_Project_MAGNIS-v1-GroundStation/Sch_MAGNIS-v1.SchDoc
PCB_Project_VESTA-v1-GroundStation/Components/Buzzer - BWSMA-KE-Z001 or CMI-1275C-050/MLT-8530/MLT-8530.PcbLib
PCB_Project_VESTA-v1-GroundStation/Components/ESP32-DEVKIT/ESP32-DEVKITC/ESP32-DEVKITC.SchLib
PCB_Project_VESTA-v1-GroundStation/Components/GPS - Ultimate GPS Breakout 66 channel Adafruit/GPS/XCVR_746.PcbLib
PCB_Project_VESTA-v1-GroundStation/Components/N-channel MOSFET Transistor, 0.27 A, 30 V - NTS4001NT1G - SC-70 (Buzzer)/NTS4001NT1G/SnapEDApcb.PcbLib
PCB_Project_VESTA-v1-GroundStation/Components/N-channel MOSFET Transistor, 0.27 A, 30 V - NTS4001NT1G - SC-70 (Buzzer)/NTS4001NT1G/SnapEDAsch.SchLib
PCB_Project_VESTA-v1-GroundStation/Components/NTS4001NT1G - SC-70 (Buzzer)/NTS4001NT1G/NTS4001NT1G.PcbLib
PCB_Project_VESTA-v1-GroundStation/Components/NTS4001NT1G - SC-70 (Buzzer)/NTS4001NT1G/NTS4001NT1G.SchLib
PCB_Project_VESTA-v1-GroundStation/Components/Pin header/TSW-106-07-S-S-LL/SAMTEC_TSW-106-07-S-S-LL.PcbLib
PCB_Project_VESTA-v1-GroundStation/Components/Pin header/TSW-106-07-S-S-LL/TSW-106-07-S-S-LL.SchLib
PCB_Project_VESTA-v1-GroundStation/Components/RF Module (LoRa) - RFM95W/Antenna-RFM95W-868S2/XCVR_RFM95W-868S2.PcbLib
PCB_Project_VESTA-v1-GroundStation/Components/SD card Slot/SD_Holder_THD2528-11SD-GF.SchLib
PCB_Project_VESTA-v1-GroundStation/Components/SMA port - BWSMA-KE-Z001/SMA/BWSMA-KE-Z001.SchLib
PCB_Project_VESTA-v1-GroundStation/Components/Switching diode (buzzer flyback) - 1N4148W/1N4148W/SODFL3816X120N.PcbLib
PCB_Project_VESTA-v1-GroundStation/PCB_Project_MAGNIS-v1-GroundStation.PrjPcb
PCB_Project_VESTA-v1-GroundStation/PCB_Project_VESTA-v1-GroundStation.PrjPcb
PCB_Project_VESTA-v1-GroundStation/PCB_VESTA-v1.PcbDoc
PCB_Project_VESTA-v1-GroundStation/Sch_MAGNIS-v1.SchDoc
PCB_Project_VESTA-v1-GroundStation/Sch_VESTA-v1.SchDoc
