Emilio-Guadarrama/MAGNIS-v1-GroundStation/(commit log)

2026-10-29 Initial VESTA v1 ground station: README and repo config
2026-10-29 Move BOM to BOM/ and add netlist
2026-10-29 Add preliminary firmware and Altium project structure
    Firmware (Firmware/VESTA_GS_v1/VESTA_GS_v1.ino) — preliminary, untested.
    Adapted from IGNIS_GroundStation_Heavy_3 (IGNIS v2 GS). Not tested: the VESTA v1 board is not finished yet.
    - Ported to ESP32-DevKitC V4 (WROOM-32D) with the VESTA v1 pin map
    - LoRa on VSPI and microSD on HSPI (separate buses)
    - MODE_SEL jumper selects rocket (0x12) or CanSat (0xAB) link profile at boot
    - SD source selectable: onboard slot or external module header; remount on write failure
    - Onboard GPS: GS position, range to rocket, GPS time sync (PC SETTIME kept as fallback)
    - Status LEDs (SD / link / GPS) and buzzer alerts
    - TelemetryPacket, CSV format and PC t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
2026-10-30 Sync firmware, netlist, BOM and README with schematic VESTA-v1-SCH-01
    - Schematic: final ESP32 pinout on native VSPI, SD card-detect left open, shells to GND, SD_CS pull-up
    - Firmware: shared VSPI bus, ext SD module on own CS/MISO, runtime PROFILE command, MLT-8530 PWM tone (untested)
    - Netlist regenerated from Sch_VESTA-v1.NET (144 pins, 26 nets, no single-pin nets)
    - BOM designators matched to the schematic; module sockets added
    - README hardware table, architecture and pin map updated
2026-10-30 Schematic dual RFM95W and PCB layout with initial routing
    Schematic (VESTA-v1-SCH-01)
    - Second RFM95W (U3) for antenna diversity: CS IO22, INT IO33, RESET IO13, shared VSPI bus
    - Second SMA (J3) and decoupling C11/C12
    - Block titles updated (ESP32-DevKitC V4, MicroSD Storage)
    PCB (PCB_VESTA-v1)
    - 100 x 100 mm 2-layer outline, 4.0 mm corner radius
    - 4x M3 mounting holes 4.0 mm from edges (3.2 mm plated, 6.0 mm GND pad)
    - Placement: SMA J1/J3 on top edge, RFM95W U2/U3 rotated 180 deg (ANT pad under SMA),
    GPS centered on top, DevKit bottom-left, CARD1 right edge, LEDs on right edge
    - Most signal routing done, GND pours on top and bottom
    - Pending: 50 ohm CPWG antenna feeds, via fence and sti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
2026-10-31 Rename board from VESTA to MAGNIS-v1
    - Rename project, schematic, PCB, BOM and firmware files/folders to MAGNIS-v1
    - Update schematic title block (MAGNIS-v1 Ground Station, MAGNIS-v1-SCH-01)
    - README: new board name, repo name, Wi-Fi SSID MAGNIS-GS and log files /MAGNIS###.CSV
2026-10-31 Rename project folders and files from VESTA to MAGNIS-v1
    - PCB_Project_VESTA-v1-GroundStation -> PCB_Project_MAGNIS-v1-GroundStation
    - Rename Altium project group, PCB project, schematic, PCB and BOM documents
2026-10-31 Update README for the MAGNIS-v1 name
    - New board and repository name
    - Wi-Fi SSID MAGNIS-GS and log files /MAGNIS###.CSV
2026-10-31 Finalize MAGNIS-v1 schematic revision 1.1
    - Reassign ESP32 GPIOs for optimized PCB routing
    - Fix dual RFM95W reset, interrupt and chip-select connections
    - Correct multifunction button wiring with 10k pull-up
    - Add I2C expansion header with optional DNP pull-ups
    - Add 22uF and 100nF decoupling capacitors
    - Add nine test points for debugging and validation
    - Remove unused GPS FIX connection
    - Simplify RF paths with direct antenna connections
    - Retain 5V magnetic buzzer circuit
    - Prepare schematic for Option B PCB layout
2026-11-02 Complete MAGNIS-v1 PCB routing and update DRC verification
    - Complete electrical routing with zero unrouted nets
    - Implement two-layer PCB routing based on Option B
    - Route dual RFM95W radios, GPS, SPI, microSD and I2C
    - Complete power distribution and ground copper pours
    - Integrate test points and updated schematic components
    - Update PCB placement and 3D visualization
    - Resolve previous unrouted connection violations
    - Confirm zero short-circuit and trace-width DRC violations
    - Reduce total DRC violations from 136 to 131
    - Document remaining clearance, mounting-hole and silkscreen issues
    - Prepare PCB for final manufacturing verification
2026-11-11 docs(MAGNIS-v1): add PCB views and PDF documentation
2026-11-11 docs: add PCB gallery and schematic PDF to README
